cepr/linbus-phat/README.md

# linbus-phat
LIN Bus interface for Raspberry PI Zero
