cepr/linbus-phat/RPi_Zero_pHat_Template.kicad_pcb

## KiCad design RPi_Zero_pHat_Template.kicad_pcb (2019-01-11)

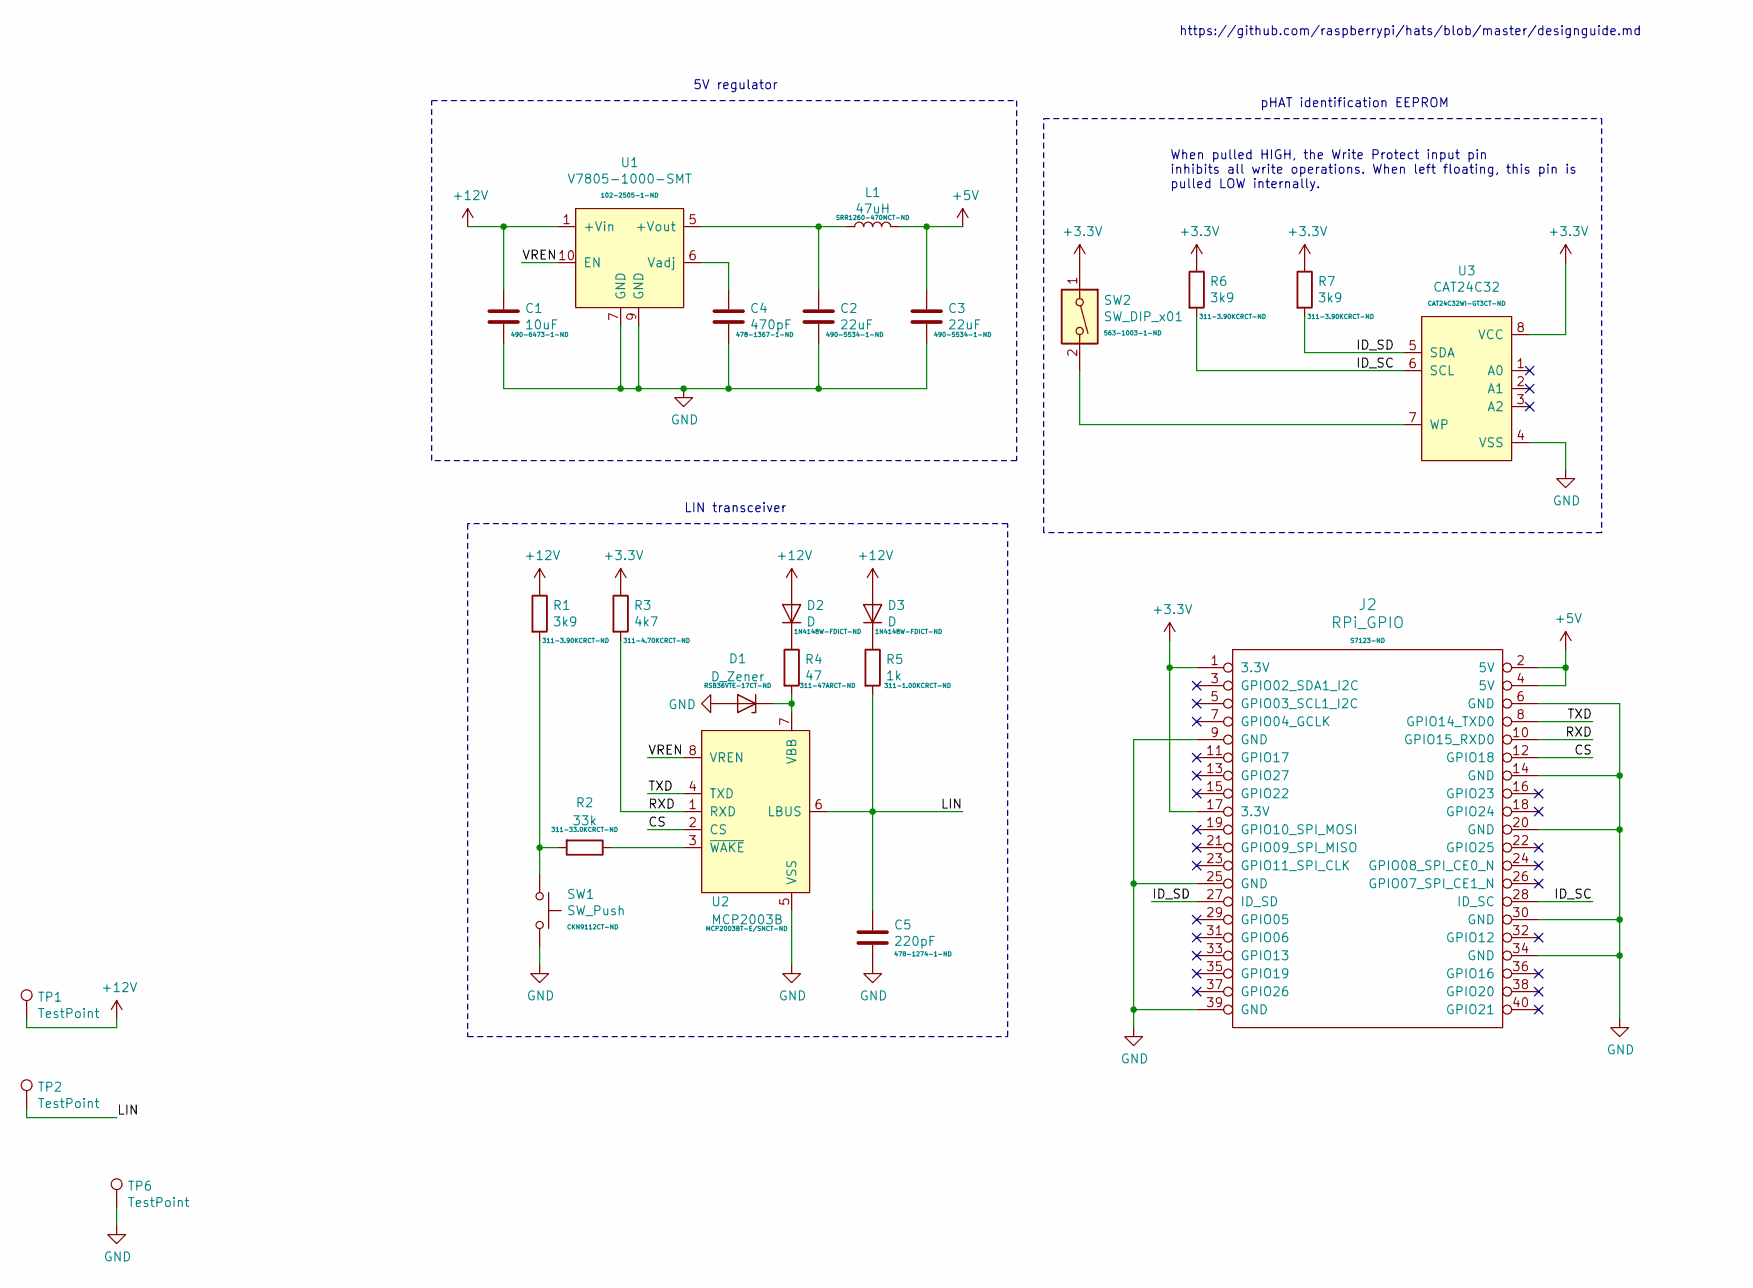
[picture p1: schematic RPi_Zero_pHat_Template.sch]

Parts:
C1: 10uF; C_0805; DIGIKEY 490-6473-1-ND
C2, C3: 22uF; C_0805; DIGIKEY 490-5534-1-ND
C4: 470pF; C_0805; DIGIKEY 478-1367-1-ND
C5: 220pF; C_0805; DIGIKEY 478-1274-1-ND
D1: D_Zener; D_SOD-323_HandSoldering; DIGIKEY RSB36VTE-17CT-ND
D2, D3: D; D_SOD-123; DIGIKEY 1N4148W-FDICT-ND
J2: RPi_GPIO; Pin_Header_Straight_2x20_Pitch2.54mm; DIGIKEY S7123-ND
L1: 47uH; BOURNS-SRR1260; DIGIKEY SRR1260-470MCT-ND
R1, R6, R7: 3k9; R_0805; DIGIKEY 311-3.90KCRCT-ND
R2: 33k; R_0805; DIGIKEY 311-33.0KCRCT-ND
R3: 4k7; R_0805; DIGIKEY 311-4.70KCRCT-ND
R4: 47; R_0805; DIGIKEY 311-47ARCT-ND
R5: 1k; R_0805; DIGIKEY 311-1.00KCRCT-ND
SW1: SW_Push; CK-PTS645; DIGIKEY CKN9112CT-ND
SW2: SW_DIP_x01; CHS-01TA; DIGIKEY 563-1003-1-ND
TP1, TP2, TP6: TestPoint; SolderWirePad_single_SMD_5x10mm
U1: V7805-1000-SMT; CUI-V78-1000-SMT; DIGIKEY 102-2505-1-ND
U2: MCP2003B; SOIC-8_3.9x4.9mm_Pitch1.27mm; DIGIKEY MCP2003BT-E/SNCT-ND
U3: CAT24C32; SOIC-8_3.9x4.9mm_Pitch1.27mm; DIGIKEY CAT24C32WI-GT3CT-ND

Connections:
+3V3: J2.1 (3.3V), J2.17 (3.3V), R3.1, R6.1, R7.1, SW2.1, U3.8 (VCC)
+5V: C3.1, J2.2 (5V), J2.4 (5V), L1.2
+12V: C1.1, D2.2 (A), D3.2 (A), R1.1, TP1.1, U1.1 (+Vin)
/CS: J2.12 (GPIO18), U2.2 (CS)
/ID_SC: J2.28 (ID_SC), R6.2, U3.6 (SCL)
/ID_SD: J2.27 (ID_SD), R7.2, U3.5 (SDA)
/LIN: C5.1, R5.2, TP2.1, U2.6 (LBUS)
/RXD: J2.10 (GPIO15_RXD0), R3.2, U2.1 (RXD)
/TXD: J2.8 (GPIO14_TXD0), U2.4 (TXD)
/VREN: U1.10 (EN), U2.8 (VREN)
GND: C1.2, C2.2, C3.2, C4.2, C5.2, D1.2 (A), J2.6 (GND), J2.9 (GND), J2.14 (GND), J2.20 (GND), J2.25 (GND), J2.30 (GND), J2.34 (GND), J2.39 (GND), SW1.2, TP6.1, U1.7 (GND), U1.9 (GND), U2.5 (VSS), U3.4 (VSS)
unnamed: C2.1, L1.1, U1.5 (+Vout)
unnamed: C4.1, U1.6 (Vadj)
unnamed: D1.1 (K), R4.2, U2.7 (VBB)
unnamed: D2.1 (K), R4.1
unnamed: D3.1 (K), R5.1
unnamed: R1.2, R2.2, SW1.1
unnamed: R2.1, U2.3 (~WAKE)
unnamed: SW2.2, U3.7 (WP)

Notes on the sheet:
When pulled HIGH, the Write Protect input pin inhibits all write operations. When left floating, this pin is pulled LOW internally.
https://github.com/raspberrypi/hats/blob/master/designguide.md
5V regulator
LIN transceiver
pHAT identification EEPROM

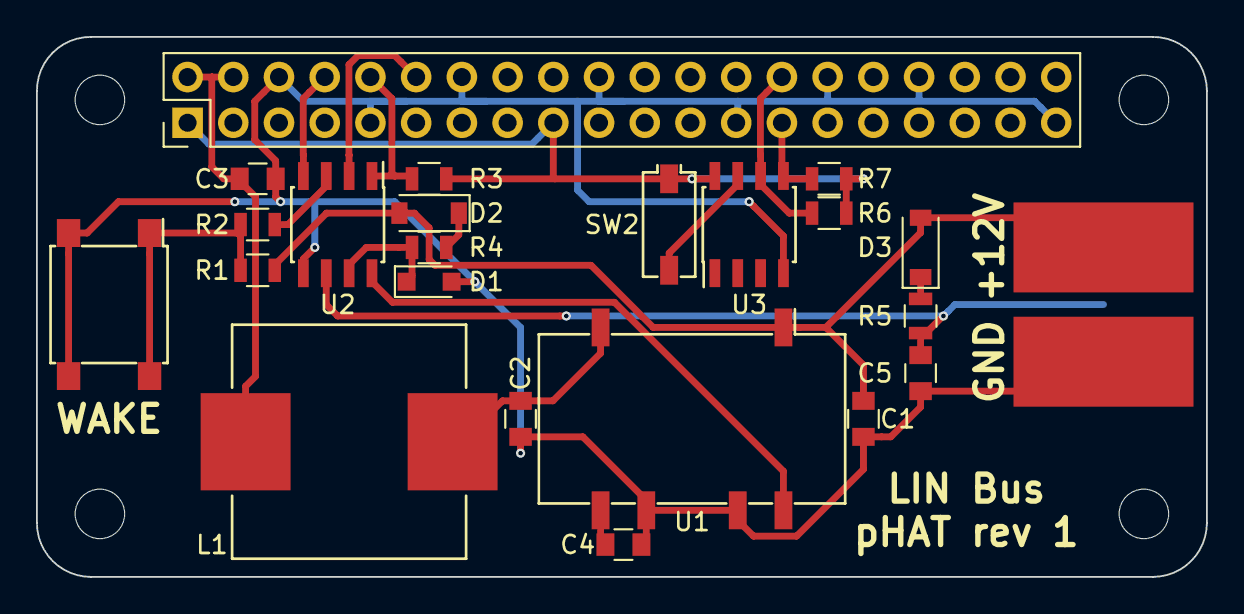
[picture p2: board RPi_Zero_pHat_Template.kicad_pcb from above]

Board: 2 copper layers, 65.0 x 30.0 mm, 25 parts (1 on the bottom side), 19 nets.
